KangaroosInAntarcitica/Aquarium/__images/aquarium.jpg

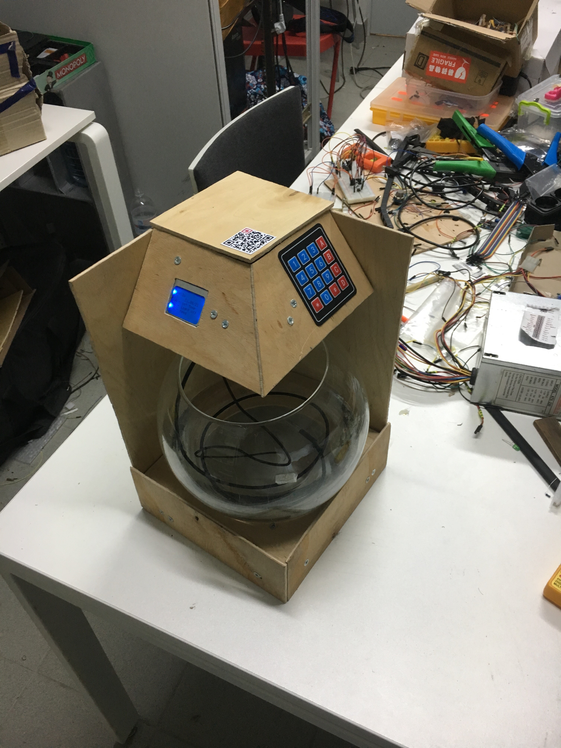
__images/aquarium.jpg
