KangaroosInAntarcitica/Aquarium/__images/aquarium_display.jpg

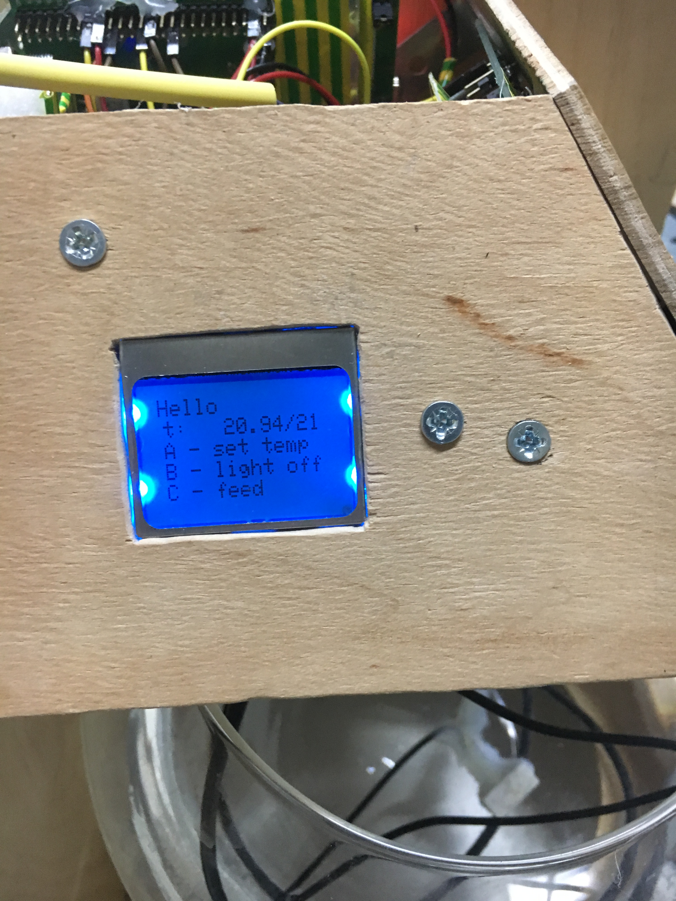
__images/aquarium_display.jpg
