KangaroosInAntarcitica/Aquarium/Src/main.c

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

/* Includes ------------------------------------------------------------------*/
#include "main.h"
#include "i2c.h"
#include "i2s.h"
#include "iwdg.h"
#include "spi.h"
#include "tim.h"
#include "usart.h"
#include "usb_host.h"
#include "gpio.h"


void SystemClock_Config(void);
void MX_USB_HOST_Process(void);

/* USER CODE BEGIN PFP */


void HAL_GPIO_EXTI_Callback(uint16_t GPIO_Pin) {
	interface_on_input(GPIO_Pin);
}

void HAL_TIM_PeriodElapsedCallback(TIM_HandleTypeDef *htim)
{
	if(htim->Instance == TIM10)
	{
		dispenser_timer_callback();
	}
}

/* USER CODE END PFP */

/* USER CODE BEGIN 0 */

// WIFI MODULE FUNCTIONS
char* request = NULL;
char first_request = 1;
char opened_dispenser = 0;

char* wifi_create_request() {
	free(request);
	request = malloc(1000);
	if (request == NULL)
		return NULL;

	char text[] = "{\"current_temperature\":%d.%02d,"
			"\"required_temperature\":%d,"
			"\"heater\":%d,"
			"\"dispenser\":%d,"
			"\"first\":%d}";
	float temperature = get_current_temperature();
	sprintf(request, text,
			(int) temperature, (int) (temperature * 100) - ((int) temperature) * 100,
			get_required_temperature(),
			heater_is_on(),
			opened_dispenser,
			first_request);

	first_request = 0;
	return request;
}

const char* WHITESPACE = " \n\t\r\v";
const char NUMBER_SPLIT = '.';
double parse_number(char* string) {
	float result = 0;
	int split_i = -1;

	for (int i = 0; string[i] != '\0'; ++i) {
		double number = (double) (string[i] - '0');

		if (number >= 0 && number <= 9) {
			if (split_i == -1)
				result = result * 10 + number;
			else {
				int fraction = i - split_i;
				for (int j = 0; j < fraction; ++j) number /= 10;
				result += number;
			}
		}
		else if (string[i] == NUMBER_SPLIT) {
			if (split_i != -1) break;
			split_i = i;
		}
		else {
			break;
		}
	}

	return result;
}

int is_whitespace(char c) {
	for (int i = 0; WHITESPACE[i] != '\0'; ++i) {
		if (WHITESPACE[i] == c) return 1;
	}
	return 0;
}

int skip_word(char* string) {
	int i = 0;
	for (; string[i] != '\0' && !is_whitespace(string[i]); ++i);
	for (; string[i] != '\0' && is_whitespace(string[i]); ++i);
	return i;
}

void read_response(char* response) {
	if (response[0]) {
		HAL_Delay(1000);
	}

	double required_temperature = parse_number(&response[0]);
	set_required_temperature(required_temperature);

	int word_start = skip_word(&response[0]);
	double open_dispenser = parse_number(&response[word_start]);
	if (open_dispenser) {
		dispenser_feed();
		opened_dispenser = 1;
	} else {
		opened_dispenser = 0;
	}
}

char* wifi_uuid = "UCU-Guests";
char* wifi_password = "";

char* url = "http://kangaroosinantarctica.pythonanywhere.com/aquarium/data";
char* response;

void wifi_module_process(WifiController* wifi_controller) {
	int is_connected = wifi_is_connected(wifi_controller);

	if (!is_connected) {
		HAL_Delay(2000);
		is_connected = wifi_is_connected(wifi_controller);
		HAL_Delay(1000);

		if (!is_connected) {
			wifi_connect(wifi_controller, wifi_uuid, wifi_password);
			HAL_Delay(5000);
		}
	}
	else {
		response = wifi_get_response(wifi_controller);
		read_response(response);

		request = wifi_create_request();
		if (request == NULL) return;
		HAL_Delay(1000);

		int result = wifi_configure_request(wifi_controller, WIFI_REQUEST_TYPE_POST, url);
		HAL_Delay(250);
		result = wifi_send_request(wifi_controller, request);

		HAL_Delay(3000);
	}
}


int cstr_size(char* str) {
	int size = 0;
	while (str[size++] != '\0') {};
	return size;
}

void init_all() {
	// Interface
	interface_init();
	interface_display();

	// Dispenser
	dispenser_init();
	// Enable interrupt for timer 10
	HAL_TIM_Base_Start_IT(&htim10);

	temperature_init();
}

/* USER CODE END 0 */

/**
  * @brief  The application entry point.
  * @retval int
  */
int main(void)
{
  /* MCU Configuration--------------------------------------------------------*/

  /* Reset of all peripherals, Initializes the Flash interface and the Systick. */
  HAL_Init();

  /* Configure the system clock */
  SystemClock_Config();

  /* Initialize all configured peripherals */
  MX_GPIO_Init();
  MX_I2C1_Init();
  MX_I2S3_Init();
  MX_SPI1_Init();
  MX_USB_HOST_Init();
  MX_SPI2_Init();
  MX_TIM10_Init();
  MX_USART2_UART_Init();
  MX_IWDG_Init();
  /* Infinite loop */
  /* USER CODE BEGIN WHILE */

  init_all();

  WifiController wifi_controller;
  wifi_init(&wifi_controller, &huart2);

  while (1)
  {
	// Perform the basic loop of the program
	IWDG->KR = 0x0000AAAAU;

	temperature_measure();
	interface_display();
	heater_adapt();

	wifi_module_process(&wifi_controller);

    /* USER CODE END WHILE */
    MX_USB_HOST_Process();

    /* USER CODE BEGIN 3 */
  }
  /* USER CODE END 3 */
}

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
