KangaroosInAntarcitica/Aquarium/Project1.ioc

Mcu.UserName=STM32F411VETx
PA10.GPIO_Label=OTG_FS_ID
PA10.Signal=USB_OTG_FS_ID
PA11.GPIO_Label=OTG_FS_DM
PA11.Signal=USB_OTG_FS_DM
PA12.GPIO_Label=OTG_FS_DP
PA12.Signal=USB_OTG_FS_DP
PA13.GPIO_Label=SWDIO
PA13.Signal=SYS_JTMS-SWDIO
PA14.GPIO_Label=SWCLK
PA14.Signal=SYS_JTCK-SWCLK
PA2.Signal=USART2_TX
PA3.Signal=USART2_RX
PA4.GPIO_Label=I2S3_WS [CS43L22_LRCK]
PA4.Signal=I2S3_WS
PA5.GPIO_Label=SPI1_SCK [L3GD20_SC/SPC]
PA5.Signal=SPI1_SCK
PA6.GPIO_Label=SPI1_MISO [L3GD20_AS0/SDO]
PA6.Signal=SPI1_MISO
PA7.GPIO_Label=SPI1_MOSI [L3GD20_SDA/SDI/SDO]
PA7.Signal=SPI1_MOSI
PA9.GPIO_Label=VBUS_FS
PA9.Signal=USB_OTG_FS_VBUS
PB10.GPIO_Label=LCD1_RST
PB10.Signal=GPIO_Output
PB12.GPIO_Label=LCD1_DC
PB12.Signal=GPIO_Output
PB13.GPIO_Label=LCD1_CLK
PB13.Signal=SPI2_SCK
PB14.GPIO_Label=LCD1_CS
PB14.Signal=GPIO_Output
PB15.GPIO_Label=LCD1_DATA
PB15.Signal=SPI2_MOSI
PB3.GPIO_Label=SWO
PB3.Signal=SYS_JTDO-SWO
PB6.GPIO_Label=Audio_SCL [CS43L22_SCL]
PB6.Signal=I2C1_SCL
PB7.Signal=GPIO_Output
PB8.Signal=S_TIM10_CH1
PB9.GPIO_Label=Audio_SDA [CS43L22_SDA]
PB9.Signal=I2C1_SDA
PC0.GPIO_Label=OTG_FS_PowerSwitchOn
PC0.Signal=GPIO_Output
PC10.GPIO_Label=I2S3_SCK [CS43L22_SCLK]
PC10.Signal=I2S3_CK
PC12.GPIO_Label=I2S3_SD [CS43L22_SDIN]
PC12.Signal=I2S3_SD
PC14-OSC32_IN.GPIO_Label=PC14-OSC32_IN
PC14-OSC32_IN.Signal=RCC_OSC32_IN
PC15-OSC32_OUT.GPIO_Label=PC15-OSC32_OUT
PC15-OSC32_OUT.Signal=RCC_OSC32_OUT
PC3.GPIO_Label=PDM_OUT [MP45DT02_DOUT]
PC3.Signal=I2S2_SD
PC7.GPIO_Label=I2S3_MCK [CS43L22_MCLK]
PC7.Signal=I2S3_MCK
PD0.Signal=GPXTI0
PD1.Signal=GPXTI1
PD10.Signal=GPIO_Output
PD11.Signal=GPIO_Output
PD12.GPIO_Label=LD4 [Green Led]
PD12.Signal=GPIO_Output
PD13.GPIO_Label=LD3 [Orange Led]
PD13.Signal=GPIO_Output
PD14.GPIO_Label=LD5 [Red Led]
PD14.Signal=GPIO_Output
PD15.GPIO_Label=LD6 [Blue Led]
PD15.Signal=GPIO_Output
PD2.Signal=GPXTI2
PD3.Signal=GPXTI3
PD4.GPIO_Label=Audio_RST [CS43L22_RESET]
PD4.Signal=GPIO_Output
PD5.GPIO_Label=OTG_FS_OverCurrent
PD5.Signal=GPIO_Input
PD8.Signal=GPIO_Output
PD9.Signal=GPIO_Output
PE15.Signal=GPIO_Output
PE2.GPIO_Label=DATA_Ready [LSM303DLHC_DRDY]
PE2.Signal=GPIO_Input
PE3.GPIO_Label=CS_I2C/SPI [L3GD20_CS_I2C/SPI]
PE3.Signal=GPIO_Output
PE4.GPIO_Label=INT1 [LSM303DLHC_INT1]
PE4.Signal=GPXTI4
PE5.GPIO_Label=INT2 [LSM303DLHC_INT2]
PE5.Signal=GPXTI5
