KangaroosInAntarcitica/Aquarium/(notices)

Notices in the files:
Src/main.c:
Copyright (c) 2018 STMicroelectronics International N.V.
All rights reserved.
(C) COPYRIGHT STMicroelectronics *****END OF FILE
